electricityforprogress/BiodataSonificationBreadboardKit/README.md

# BiodataSonificationBreadboardKit
Biodata Sonification kit using breadboard, for Arduino Uno 'Sheild'
