electricityforprogress/BiodataSonificationBreadboardKit/GalvShield_005.brd

## EAGLE design GalvShield_005.brd (2017-02-04)

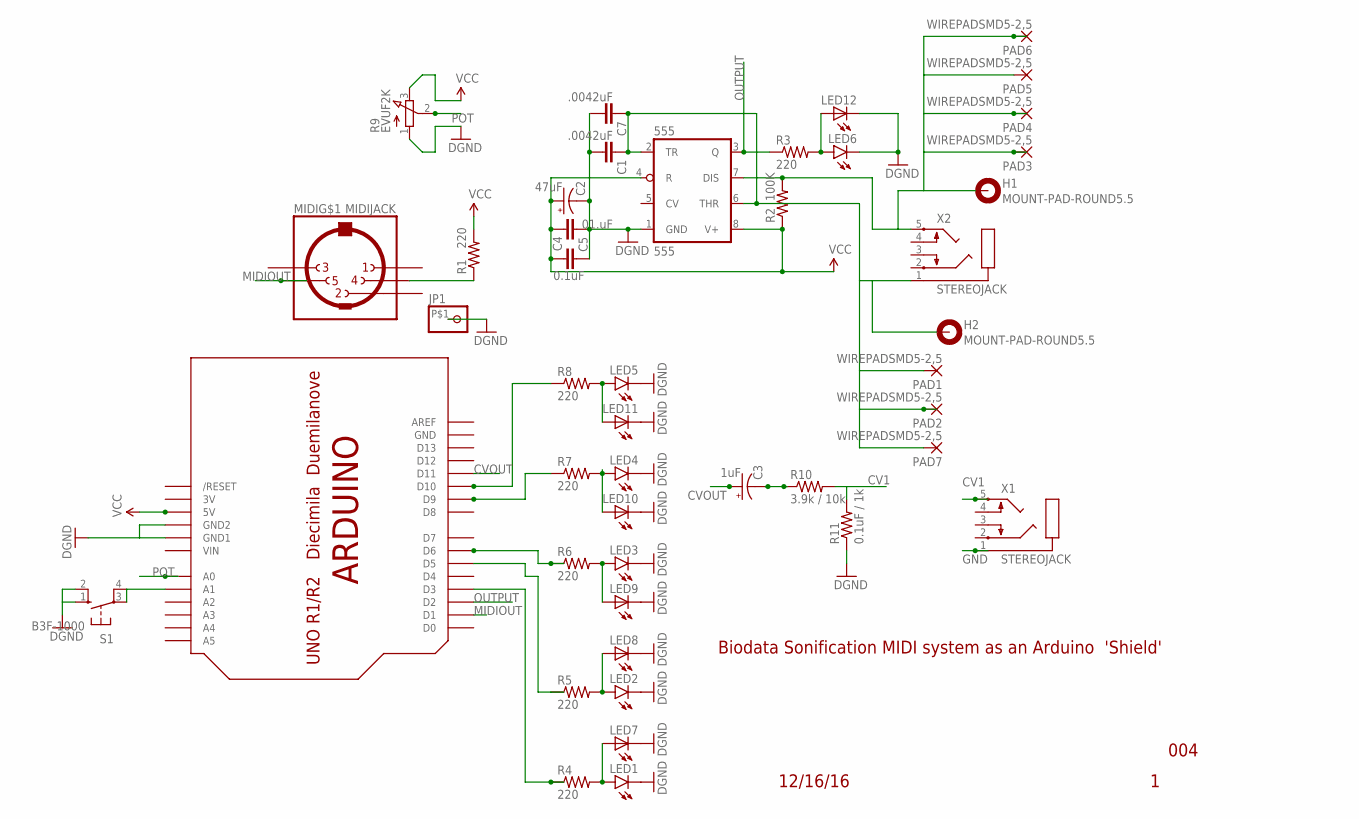
[picture p1: schematic GalvShield_005.sch]

Parts:
555: 555; DIL08-ROUND
C1: .0042uF; CAP-PTH-SMALL
C2: 47uF; CPOL-RADIAL-10UF-25V
C3: 1uF; CPOL-RADIAL-10UF-25V
C4: 0.1uF; CAP-PTH-SMALL
C5: 01.uF; 1206
C7: .0042uF; 1206
H1, H2: MOUNT-PAD-ROUND5.5; 5,5-PAD
JP1: PINHD-1X1-BIGPOGO; 1X1-BIGPOGO
LED1, LED2, LED3, LED4, LED5, LED6: LED5MM
LED7, LED8, LED9, LED10, LED11, LED12: LEDSML1206; SML1206
MIDI: MIDIJACK; CP-2350
PAD1, PAD2, PAD3, PAD4, PAD5, PAD6, PAD7: WIREPADSMD5-2,5; 5-2,5
R1, R3, R4, R5, R6, R7, R8: 220; 0805-THM-7
R2: 100K; 0805-THM-7
R9: EVUF2K; EVUFXK
R10: 3.9k / 10k; 0805-THM-7
R11: 0.1uF / 1k; 0805-THM-7
S1: B3F-1000; B3F-10XX
U$3: ARDUINOUNO; ARDUINO
X1, X2: STEREOJACK; STX3100

Connections:
3V: U$3.3V
CV1: R10.2, R11.2, X1.5
CVOUT: C3.1 (+), U$3.D11
GND: 555.1 (GND), C1.2, C2.2 (-), C4.2, C5.1, C7.2, JP1.P$1, LED1.K (C), LED2.K (C), LED3.K (C), LED4.K (C), LED5.K (C), LED6.K (C), LED7.C, LED8.C, LED9.C, LED10.C, LED11.C, LED12.C, R9.1 (A), R11.1, S1.1 (S), S1.2 (S1), U$3.GND, U$3.GND1, U$3.GND2, X1.1
MIDIOUT: MIDI.5, U$3.D1
unnamed: C3.2 (-), R10.1
unnamed: S1.3, S1.4 (P1), U$3.A1
unnamed: R8.1, U$3.D10
unnamed: R4.1, U$3.D3
unnamed: R5.1, U$3.D5
unnamed: MIDI.4, R1.1
unnamed: R7.1, U$3.D9
unnamed: R6.1, U$3.D6
unnamed: LED1.A, LED7.A, R4.2
unnamed: LED2.A, LED8.A, R5.2
unnamed: LED3.A, LED9.A, R6.2
unnamed: LED4.A, LED10.A, R7.2
unnamed: LED5.A, LED11.A, R8.2
unnamed: LED6.A, LED12.A, R3.2
OUTPUT: 555.3 (Q), R3.1, U$3.D2
POT: R9.2 (S), U$3.A0
PROBE1: 555.2 (TR), 555.6 (THR), C1.1, C7.1, H2.B5,5, PAD1.1, PAD2.1, PAD7.1, X2.1
PROBE2: 555.7 (DIS), H1.B5,5, PAD3.1, PAD4.1, PAD5.1, PAD6.1, R2.2, X2.5
VCC: 555.4 (R), 555.8 (V+), C2.1 (+), C4.1, C5.2, R1.2, R2.1, R9.3 (E), U$3.5V
VIN: U$3.VIN

Notes on the sheet:
12/16/16
004
Biodata Sonification MIDI system as an Arduino 'Shield'

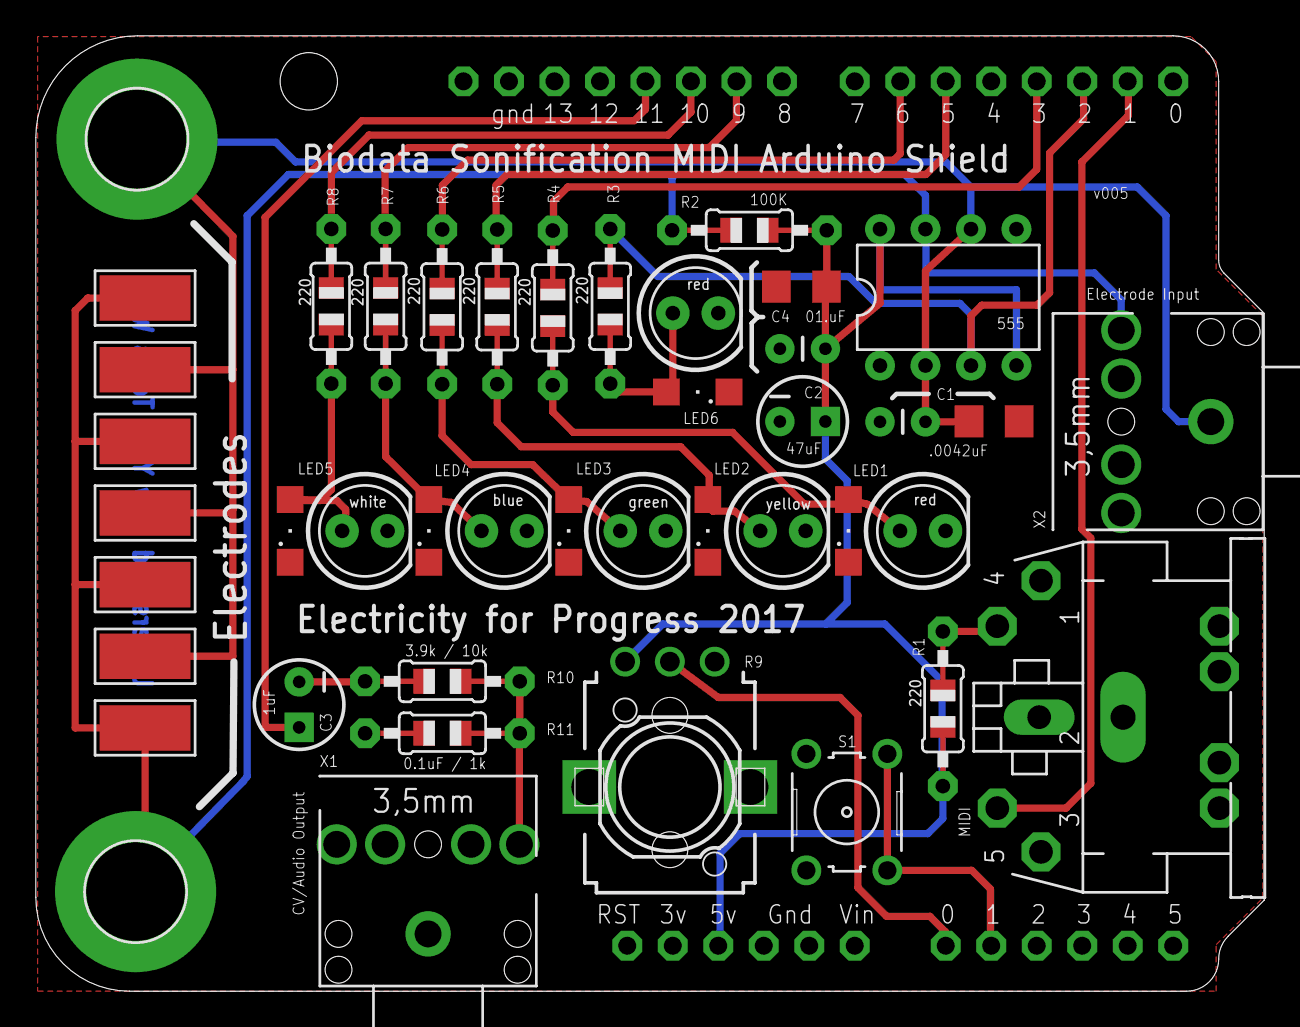
[picture p2: board GalvShield_005.brd from above]

Board: 2 copper layers, 68.6 x 53.3 mm, 45 parts (0 on the bottom side), 23 nets.
