electricityforprogress/BiodataSonificationBreadboardKit/(threads)

Thread 1 (2020-12-02):

Menu problem

mic066, 2020-12-02:
Seems like there is a sort of problem with the menu. I can enter the menu via the push button, but LEDs stop flashing when turning the pot a couple of times (it's actually very random: sometimes I can scroll the menu once, some times twice, sometimes never). Even though LEDs don't flash, I can enter the submenu, but only for led number 1 (threshold mode) and led number 4 (brightness mode). I guess there is something strange either in the "checkButton" or "checkMenu" functions, but I cannot find the problem. Has anyone had and fixed this problem?

aspidonia, 2021-02-16:
I ran into similar issues which made using the physical menu navigation frustrating and irregular. I am just starting to get reoriented with my build but it looks like what I did was eliminate the
**" leds[prevValue].stop_fade(); "** under peripherals.

I also changed the brightness of the menu and submenus to make it more distinctive.

I also don't know what I'm doing, but somehow it seems to work better.

Through the lens of an end user of this as a product, I think I mostly understand the design considerations and limitations of getting to have a few things to be able to change, and a way to change them.

that being said, it feels like a limiting compromise and I've found a better creative and exploratory flow accessing and manipulating variables via the code vs the physical menu.

electricityforprogress, 2022-03-07:
Sorry that the menu has been challenging for many users.  I have had a 50% response for users who have the menus working fine.  Checkout my new Biodata Feather repository, using an ESP32 module for Bluetooth and wifi, the Menu mode functions smoothly in the new codebase.  Also Manuel's code sometimes works bettter for users:  https://github.com/electricityforprogress/midi-biodata

Closed 2022-03-07.

Thread 3 (2021-11-26):

Problems finding midi 5 din

Cyb3rDan-098, 2021-11-26:
I don't find midi 5 din conector. Can you suggest me a solution to output the sound? With a buzzer is posible?

electricityforprogress, 2022-03-07:
This device does not output sound.   Changes in electrical conductivity are translated into MIDI notes which can create sound with a synthesizer, phone, or computer.

Closed 2022-03-07.

Thread 4 (2022-02-25):

Biodata sonification code

rvouger, 2022-02-25:
I tired uploading the code after building the kit with an uno r3, there was a few problems with things not declared in the scope and things does not name a type. I'm not so sure how to fix these problems, has anyone else tried to run this recently?

rvouger, 2022-02-25:
Arduino: 1.8.19 (Mac OS X), Board: "Arduino Uno"

these are the error messages:

hghghgh:35:1: error: 'Bounce' does not name a type; did you mean 'tone'?
 Bounce button = Bounce(); //debounce button using Bounce2
 ^~~~~~
 tone
hghghgh:75:1: error: 'LEDFader' does not name a type
 LEDFader leds[LED_NUM] = { // 6 LEDs (perhaps 2 RGB LEDs)
 ^~~~~~~~
/Users/cherrysong/Documents/Arduino/hghghgh/hghghgh.ino: In function 'void setup()':
hghghgh:105:3: error: 'button' was not declared in this scope
   button.attach(buttonPin);
   ^~~~~~
/Users/cherrysong/Documents/Arduino/hghghgh/hghghgh.ino:105:3: note: suggested alternative: 'buttonPin'
   button.attach(buttonPin);
   ^~~~~~
   buttonPin
/Users/cherrysong/Documents/Arduino/hghghgh/hghghgh.ino: In function 'void setNote(int, int, long int, int)':
hghghgh:158:17: error: 'leds' was not declared in this scope
             if(!leds[j].is_fading()) { rampUp(i, maxBrightness, duration);  break; }
                 ^~~~
/Users/cherrysong/Documents/Arduino/hghghgh/hghghgh.ino:158:17: note: suggested alternative: 'gets'
             if(!leds[j].is_fading()) { rampUp(i, maxBrightness, duration);  break; }
                 ^~~~
                 gets
hghghgh:162:17: error: 'leds' was not declared in this scope
             if(!leds[j].is_fading()) { rampUp(i, maxBrightness, duration);  break; }
                 ^~~~
/Users/cherrysong/Documents/Arduino/hghghgh/hghghgh.ino:162:17: note: suggested alternative: 'gets'
             if(!leds[j].is_fading()) { rampUp(i, maxBrightness, duration);  break; }
                 ^~~~
                 gets
/Users/cherrysong/Documents/Arduino/hghghgh/hghghgh.ino: In function 'void rampUp(int, int, int)':
hghghgh:269:1: error: 'LEDFader' was not declared in this scope
 LEDFader *led = &leds[ledPin];
 ^~~~~~~~
hghghgh:269:11: error: 'led' was not declared in this scope
 LEDFader *led = &leds[ledPin];
           ^~~
hghghgh:269:18: error: 'leds' was not declared in this scope
 LEDFader *led = &leds[ledPin];
                  ^~~~
/Users/cherrysong/Documents/Arduino/hghghgh/hghghgh.ino:269:18: note: suggested alternative: 'gets'
 LEDFader *led = &leds[ledPin];
                  ^~~~
                  gets
/Users/cherrysong/Documents/Arduino/hghghgh/hghghgh.ino: In function 'void rampDown(int, int, int)':
hghghgh:276:3: error: 'LEDFader' was not declared in this scope
   LEDFader *led = &leds[ledPin];
   ^~~~~~~~
hghghgh:276:13: error: 'led' was not declared in this scope
   LEDFader *led = &leds[ledPin];
             ^~~
hghghgh:276:20: error: 'leds' was not declared in this scope
   LEDFader *led = &leds[ledPin];
                    ^~~~
/Users/cherrysong/Documents/Arduino/hghghgh/hghghgh.ino:276:20: note: suggested alternative: 'gets'
   LEDFader *led = &leds[ledPin];
                    ^~~~
                    gets
/Users/cherrysong/Documents/Arduino/hghghgh/hghghgh.ino: In function 'void checkLED()':
hghghgh:284:5: error: 'LEDFader' was not declared in this scope
     LEDFader *led = &leds[i];
     ^~~~~~~~
hghghgh:284:15: error: 'led' was not declared in this scope
     LEDFader *led = &leds[i];
               ^~~
hghghgh:284:22: error: 'leds' was not declared in this scope
     LEDFader *led = &leds[i];
                      ^~~~
/Users/cherrysong/Documents/Arduino/hghghgh/hghghgh.ino:284:22: note: suggested alternative: 'gets'
     LEDFader *led = &leds[i];
                      ^~~~
                      gets
/Users/cherrysong/Documents/Arduino/hghghgh/hghghgh.ino: In function 'void checkButton()':
hghghgh:291:3: error: 'button' was not declared in this scope
   button.update();
   ^~~~~~
/Users/cherrysong/Documents/Arduino/hghghgh/hghghgh.ino:291:3: note: suggested alternative: 'buttonPin'
   button.update();
   ^~~~~~
   buttonPin
hghghgh:295:35: error: 'leds' was not declared in this scope
     for(byte j=0;j<LED_NUM;j++) { leds[j].stop_fade(); leds[j].set_value(0); } //off LEDs
                                   ^~~~
/Users/cherrysong/Documents/Arduino/hghghgh/hghghgh.ino:295:35: note: suggested alternative: 'gets'
     for(byte j=0;j<LED_NUM;j++) { leds[j].stop_fade(); leds[j].set_value(0); } //off LEDs
                                   ^~~~
                                   gets
/Users/cherrysong/Documents/Arduino/hghghgh/hghghgh.ino: In function 'void checkMenu()':
hghghgh:350:9: error: 'leds' was not declared in this scope
         leds[prevValue].stop_fade();
         ^~~~
/Users/cherrysong/Documents/Arduino/hghghgh/hghghgh.ino:350:9: note: suggested alternative: 'gets'
         leds[prevValue].stop_fade();
         ^~~~
         gets
hghghgh:378:9: error: 'leds' was not declared in this scope
         leds[prevValue].stop_fade();
         ^~~~
/Users/cherrysong/Documents/Arduino/hghghgh/hghghgh.ino:378:9: note: suggested alternative: 'gets'
         leds[prevValue].stop_fade();
         ^~~~
         gets
/Users/cherrysong/Documents/Arduino/hghghgh/hghghgh.ino: In function 'void checkBattery()':
hghghgh:408:37: error: 'leds' was not declared in this scope
       for(byte j=0;j<LED_NUM;j++) { leds[j].stop_fade(); leds[j].set_value(0); }  //reset leds, power savings
                                     ^~~~
/Users/cherrysong/Documents/Arduino/hghghgh/hghghgh.ino:408:37: note: suggested alternative: 'gets'
       for(byte j=0;j<LED_NUM;j++) { leds[j].stop_fade(); leds[j].set_value(0); }  //reset leds, power savings
                                     ^~~~
                                     gets
/Users/cherrysong/Documents/Arduino/hghghgh/hghghgh.ino: In function 'void pulse(int, int, int)':
hghghgh:421:2: error: 'LEDFader' was not declared in this scope
  LEDFader *led = &leds[ledPin];
  ^~~~~~~~
hghghgh:421:12: error: 'led' was not declared in this scope
  LEDFader *led = &leds[ledPin];
            ^~~
hghghgh:421:19: error: 'leds' was not declared in this scope
  LEDFader *led = &leds[ledPin];
                   ^~~~
/Users/cherrysong/Documents/Arduino/hghghgh/hghghgh.ino:421:19: note: suggested alternative: 'gets'
  LEDFader *led = &leds[ledPin];
                   ^~~~
                   gets
/Users/cherrysong/Documents/Arduino/hghghgh/hghghgh.ino: In function 'void bootLightshow()':
hghghgh:433:5: error: 'LEDFader' was not declared in this scope
     LEDFader *led = &leds[i-1];
     ^~~~~~~~
hghghgh:433:15: error: 'led' was not declared in this scope
     LEDFader *led = &leds[i-1];
               ^~~
hghghgh:433:22: error: 'leds' was not declared in this scope
     LEDFader *led = &leds[i-1];
                      ^~~~
/Users/cherrysong/Documents/Arduino/hghghgh/hghghgh.ino:433:22: note: suggested alternative: 'gets'
     LEDFader *led = &leds[i-1];
                      ^~~~
                      gets
/Users/cherrysong/Documents/Arduino/hghghgh/hghghgh.ino: In function 'void thresholdMode()':
hghghgh:476:5: error: 'button' was not declared in this scope
     button.update();
     ^~~~~~
/Users/cherrysong/Documents/Arduino/hghghgh/hghghgh.ino:476:5: note: suggested alternative: 'buttonPin'
     button.update();
     ^~~~~~
     buttonPin
hghghgh:483:3: error: 'leds' was not declared in this scope
   leds[prevValue].stop_fade();
   ^~~~
/Users/cherrysong/Documents/Arduino/hghghgh/hghghgh.ino:483:3: note: suggested alternative: 'gets'
   leds[prevValue].stop_fade();
   ^~~~
   gets
/Users/cherrysong/Documents/Arduino/hghghgh/hghghgh.ino: In function 'void scaleMode()':
hghghgh:500:7: error: 'leds' was not declared in this scope
       leds[prevScale].stop_fade();
       ^~~~
/Users/cherrysong/Documents/Arduino/hghghgh/hghghgh.ino:500:7: note: suggested alternative: 'gets'
       leds[prevScale].stop_fade();
       ^~~~
       gets
hghghgh:510:5: error: 'button' was not declared in this scope
     button.update();
     ^~~~~~
/Users/cherrysong/Documents/Arduino/hghghgh/hghghgh.ino:510:5: note: suggested alternative: 'buttonPin'
     button.update();
     ^~~~~~
     buttonPin
hghghgh:517:3: error: 'leds' was not declared in this scope
   leds[prevValue].stop_fade();
   ^~~~
/Users/cherrysong/Documents/Arduino/hghghgh/hghghgh.ino:517:3: note: suggested alternative: 'gets'
   leds[prevValue].stop_fade();
   ^~~~
   gets
/Users/cherrysong/Documents/Arduino/hghghgh/hghghgh.ino: In function 'void channelMode()':
hghghgh:538:5: error: 'button' was not declared in this scope
     button.update();
     ^~~~~~
/Users/cherrysong/Documents/Arduino/hghghgh/hghghgh.ino:538:5: note: suggested alternative: 'buttonPin'
     button.update();
     ^~~~~~
     buttonPin
hghghgh:545:3: error: 'leds' was not declared in this scope
   leds[prevValue].stop_fade();
   ^~~~
/Users/cherrysong/Documents/Arduino/hghghgh/hghghgh.ino:545:3: note: suggested alternative: 'gets'
   leds[prevValue].stop_fade();
   ^~~~
   gets
/Users/cherrysong/Documents/Arduino/hghghgh/hghghgh.ino: In function 'void brightnessMode()':
hghghgh:564:5: error: 'button' was not declared in this scope
     button.update();
     ^~~~~~
/Users/cherrysong/Documents/Arduino/hghghgh/hghghgh.ino:564:5: note: suggested alternative: 'buttonPin'
     button.update();
     ^~~~~~
     buttonPin
hghghgh:571:3: error: 'leds' was not declared in this scope
   leds[prevValue].stop_fade();
   ^~~~
/Users/cherrysong/Documents/Arduino/hghghgh/hghghgh.ino:571:3: note: suggested alternative: 'gets'
   leds[prevValue].stop_fade();
   ^~~~
   gets
/Users/cherrysong/Documents/Arduino/hghghgh/hghghgh.ino: In function 'void analyzeSample()':
/Users/cherrysong/Documents/Arduino/hghghgh/hghghgh.ino:632:37: warning: invalid conversion from 'int' to 'int*' [-fpermissive]
        setnote = scaleNote(setnote, *scale[currScale], root);  //scale the note
                                     ^~~~~~~~~~~~~~~~~
/Users/cherrysong/Documents/Arduino/hghghgh/hghghgh.ino:657:5: note:   initializing argument 2 of 'int scaleNote(int, int*, int)'
 int scaleNote(int note, int scale[], int root) {
     ^~~~~~~~~
exit status 1
'Bounce' does not name a type; did you mean 'tone'?

This report would have more information with
"Show verbose output during compilation"
option enabled in File -> Preferences.

sickozell, 2022-03-05:
I had problems compiling it with arduino nano at line 632:
setnote = scaleNote(setnote, *scale[currScale], root);  //scale the note
That * seemed to be the problem, but I don't know how to fix pointers issues, so I'm trying to write a new routine to calculate scales without them

electricityforprogress, 2022-03-07:
Hey I have gotten a couple comments about the setNote pointer.  The main MIDI Sprout code and my new Biodata Feather  code do not include the star.  I have updated the codebase to reflect a direct reference to the scaleNote array.

Closed 2022-03-07.

Thread 7 (2022-07-27):

Issue with getting the project to work with computer

laxelh, 2022-07-27:
Hello,

I have built the project and uploaded the code successfully but I am having an issue with getting a sound output. I don't own a modular synth but I bought a Midi to USB cable to use with garageband. When I plug the cable into the board and my computer, the computer detects it as a Midi input but when I switch the board on and try to get it to output something, it doesn't work. Any suggestions on how I can get it to work?

Gardemia, 2022-08-25:
Is because you need to conect the port number 2 of the midi (the center of the midi) to ground.
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

Xvex34, 2022-09-30:
Hello, im a diyi guy from the midwest and my girlfriend wants to hear her plants sing to her.

My goal is to complete this project for her birthday this November, but hit a bump in the road…

Can you use this project on iPhone garage band? I got the MIDI cable to usb to iPhone converter cable. And yes I grounded the MIDI port on the bread board but no sound.

please let me know

Thanks.

electricityforprogress, 2022-10-01:
MIDI inputs DO NOT require ground connection ... in fact the most important part about MIDI is electrical isoloation.  Only pins 4 and 5 are needed for the sink (TX output) and the pull up voltage through a resistor (the orange and red lines in the image above)

@Xvex34 If you want to connect to an iphone, you should use the new version of the device which utilizes an Adafruit Feather ESP32 and can connect using Bluetooth very easily (no cable).

Careful with cheap USB-MIDI cables ... they simply DO NOT WORK.  I use the Emu XMIDI 1x1 as a simple USB-MIDI device.  Use a known brand name and you should be fine.

Closed 2022-10-01.

Thread 8 (2022-07-29):

Convert eagle files to gerber

inktrap, 2022-07-29:
I would like to have a gerber file of the arduino breadboard-shield to upload to some pcb manufacturers to get a quote, e.g. pcbway which has a an online gerber view. Btw. I tried to place an order via your store for the feather-pcb, but it wouldn't accept my adress which is strange, I live in Germany.  So if I can't order the feather-pcb I would appreciate a gerber file of that as well (would be useful to have anyaways, right?). Btw., I would really find it unfair if someone re-used the designs for commercial purposes, but I guess [MIT](https://github.com/electricityforprogress/BiodataFeather/blob/master/LICENSE) would allow it.

I checked how to convert this (I am totally new to pcb design) and can open the `sch` and `brd` files with kicad and do an auto-matching of the layers, but the milling layer is not matched and I don't know how much of a problem that is and I also don't know if the auto-matching introduced any mistakes.

I would tend to build this the arduino way, because it seems much easier to get started with arduino than with feather, but regarding this project, the feather way seems to be much easier and less effort, also it offers more features out of the box, like wifi and bluetooth, whereas the arduino way is midi via a socket. Do you have any plans to add a [bluetooth](https://create.arduino.cc/projecthub/electropeak/getting-started-with-hc-05-bluetooth-module-arduino-e0ca81) or [wifi](https://www.arduino.cc/en/Guide/ArduinoWiFiShield) to that? I guess it wouldn't make that much sense because feather has it integrated already.

inktrap, 2022-07-29:
Hey so I downloaded eagle and was able to convert these to gerber files and the various services happily accepted these. I am leaving this open and will wait for feedback from you. Perhaps you want to add the files yourself, or I could create a PR. Also it might help to add some recommendations how to order this (lead-free solder, aso.)?

Closed 2022-10-01.

Thread 9 (2022-10-13):

Wrong resistor in parts list

samsiljee, 2022-10-13:
Hi all,

Just a heads up, the parts list at the top of the pdf asks for a 100 ohm resistor, whereas page 9, where the resistor is used as a pull-up requires a 100k ohm resistor.
I ordered the wrong ones myself! Hopefully the 120k ohm I used as a replacement will suffice!
Thank you for making this project available, very exciting!

Regards,

Sam

Thread 11 (2023-08-20):

"avrdude: stk500_getsync() attempt 1 of 10: not in sync: resp=0xb3"

simflex46, 2023-08-20:
Hello I'm doing this biodata sonification project, but there's a problem as soon as I send the code to my arduino I get this message :
"avrdude: stk500_getsync() attempt 1 of 10: not in sync: resp=0xb3"
I understood that it was coming from RX, I looked on the internet and tried all the solutions available, unfortunately nothing worked. Does anyone have any ideas ?
Thanks a lot!

Closed 2023-08-20.

Thread 12 (2024-02-26):

Component values for the resistors in the CV out circuit

brightmind3, 2024-02-26:
Hello,

Both the schematic and board EAGLE files for the Arduino shield show a CV out circuit, consisting of one capacitor (C3), two resistors (R10 and R11) and an audio jack (X1). It is not described in the pdf, but you can see it build on page 59 of the same document.

I want to build the Arduino shield, but the resistor values for R10 and R11 are very confusing. R10 is marked 3.9k / 10k, and R11 is marked 0.1uF / 1k. Especially for R11, 0.1uF is a capacitor value, not a resistor value.

So:

- Is this circuit meant to be a low-pass filter?
- Should the component labeled as R11 be a resistor or a capacitor?
- What are the correct values for these two components?
