electricityforprogress/BiodataSonificationBreadboardKit/(commit log)

2017-02-06 arduino sketch v026
    sketch update for the breadboard and arduino shield kits
2017-02-06 Kit assembly instruction guide v01
2017-02-06 Kit assembly Instructions
2017-02-07 Changes to Menu mode LED display
2017-02-11 Arduino Sketch with multiple tabs
2021-02-02 updated slide 9
    changed slide 9 to indicate correct row for 100k pull up resistor
2021-02-16 modified 555 timer with link
    [Arduino Shield Biodata Sonification - Parts.csv]
2021-02-16 555 change
    [Arduino Shield Biodata Sonification - Parts.csv]
2022-03-07 change setNote
    i had a couple comments about the setNote and star. I looked and the MIDISprout and my new Biodata Feather do not use the star, so i have updated the code here.
